ChrossChris/RemoteControlArduino/doc/Fernsteuerung (innen).jpg

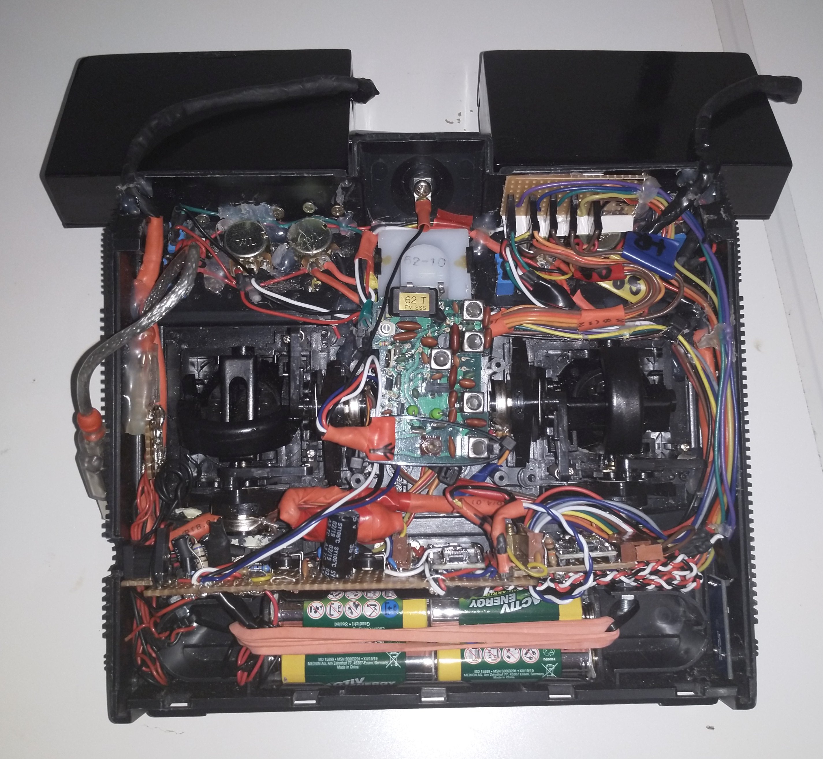
doc/Fernsteuerung (innen).jpg
