ChrossChris/RemoteControlArduino/doc/Fernsteuerung (außen).jpg

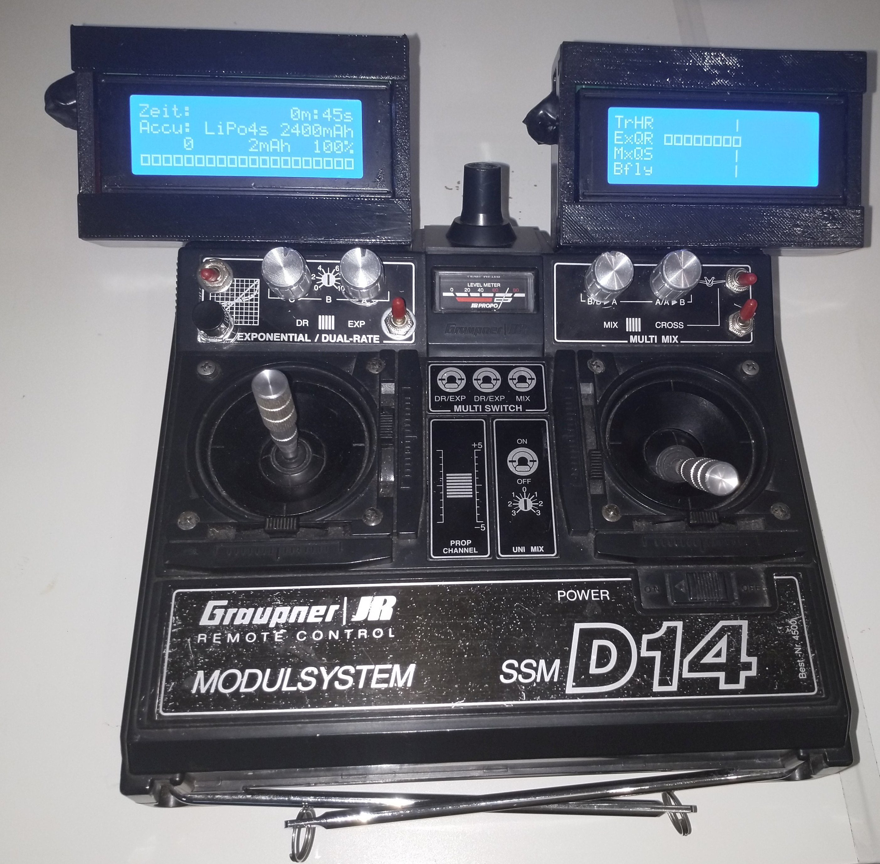
doc/Fernsteuerung (außen).jpg
