ChrossChris/RemoteControlArduino/doc/Hauptplatine.png

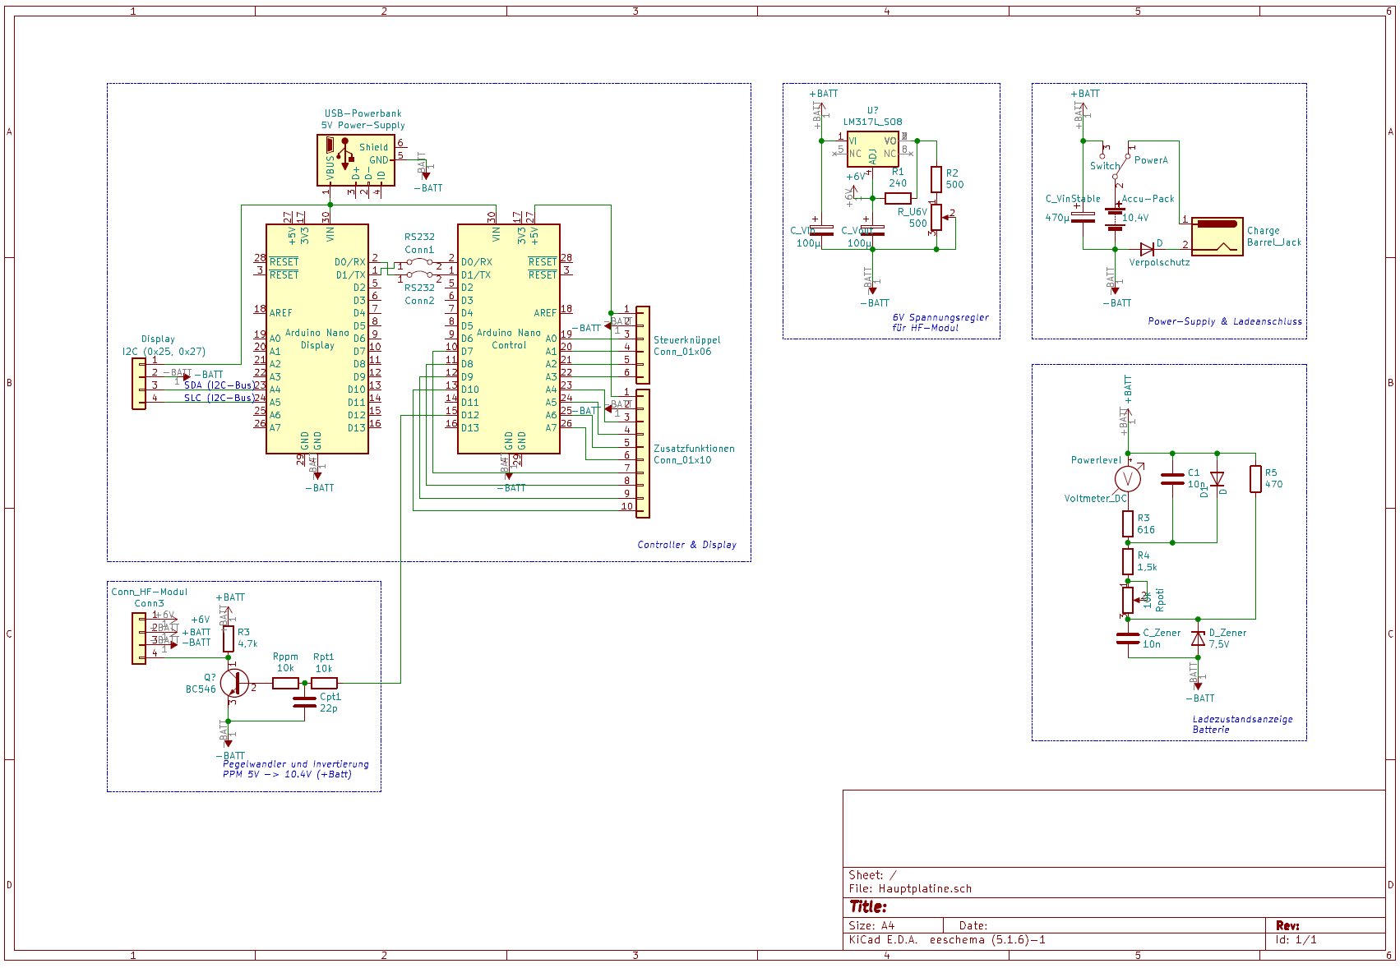
doc/Hauptplatine.png
